evyd13/dodo67/README.md

# Dodo67 PCB

## Daughterboard
Doro67 replacement daughterboard PCB

Check out the daughterboard under `daughterboard/`.

## PCB
The Dodo67 PCB will be uploaded later.
