evyd13/dodo67/pcb/manufacturing/Dodo67 BOM.xls

Dodo67 BOM
Manufacturer | Manufacturer Part Number (required) | Designator (required) | Qty (required) | Description (required) | Case | SMD ,BGA,LCC,OR TH | Top/Bottom | points (number of contacts the IC has in each board) | Total points (number of contacts per BOM line has) | Comment
Samsung Electro-Mechanics | CL21B104KBCNNNC | C1-C3 | 3 | 100nf capacitor | 0805 | SMD | Bottom
Samsung Electro-Mechanics | CL21A475KAQNNNE | C4 | 1 | 4.7uf capacitor | 0805 | SMD | Bottom
Samsung Electro-Mechanics | CL21A105KBCLNNC | C5 | 1 | 1uf capacitor | 0805 | SMD | Bottom
LIZ Elec | CD4148WSP | D1-D31, D33-D47, D49-D63, D65-D67, D71, D74-D79 | 71 | Switching diode | 0805 | SMD | Bottom
Walsin Tech Corp | WR08X103JTL | R3, R4 | 2 | 10k ohm resistor | 0805 | SMD | Bottom
Walsin Tech Corp | WR08X220JTL | R1, R2 | 2 | 22 ohm resistor | 0805 | SMD | Bottom
Walsin Tech Corp | WR08X471JTL | R5 | 1 | 470 ohm resistor | 0805 | SMD | Bottom
Microchip Tech | ATMEGA32U4-AU | U1 | 1 | Microcontroller | QFP-44 | SMD | Bottom |  |  | Do not substitute
STMicroelectronics | USBLC6-2SC6 | U2 | 1 | Diode ESD | SOT-23-6 | SMD | Bottom |  |  | Do not substitute
Korean Hroparts Elec | K2-1187SQ-A4SW-06 | SW1 | 1 | Tactile switch |  | SMD | Bottom
Murata Electronics | CSTNE16M0V530000R0 | X1 | 1 | Resonator |  | SMD | Bottom |  |  | Do not substitute
TLC Electronic | TLC-PSMD050 | F1 | 1 | PTC Fuse | 0805 | SMD | Bottom |  |  | Do not substitute
JST Sales America | SM04B-SRSS-TB(LF)(SN) | J3 | 1 | Board connector |  | SMD | Bottom |  |  | Do not substitute
Worldsemi | WS2813B | RGB1-RGB8 | 8 | RGB LED | 5050 | SMD | Bottom |  |  | Do not substitute
