evyd13/dodo67/daughterboard/manufacturing/Dodo67 daughterboard BOM.xls

Dodo67 Daughterboard BOM
Manufacturer | Manufacturer Part Number (required) | Designator (required) | Qty (required) | Description (required) | Case | SMD ,BGA,LCC,OR TH | Top/Bottom | points (number of contacts the IC has in each board) | Total points (number of contacts per BOM line has) | Comment
Korean Hroparts Elec | TYPE-C-31-M-12 | J1 | 1 | USB-C female connector |  | SMD + TH | Top
JST Sales America | SM04B-SRSS-TB(LF)(SN) | J2 | 1 | Male board connector 1.00mm pitch |  | SMD | Top
TLC Electronic | TLC-PSMD050 | F1 | 1 | Polyfuse 500mA/1A | 0805 | SMD | Top
Walsin Tech Corp | WR08X512JTL | R1, R2 | 2 | 5.1k Ohm resistor | 0805 | SMD | Top
STMicroelectronics | USBLC6-2SC6 | U1 | 1 | ESD protection diode | SOT23-6 | SMD | Top
