evyd13/dodo67/daughterboard/daughterboard.kicad_pcb

## KiCad design daughterboard/daughterboard.kicad_pcb (2022-03-01)

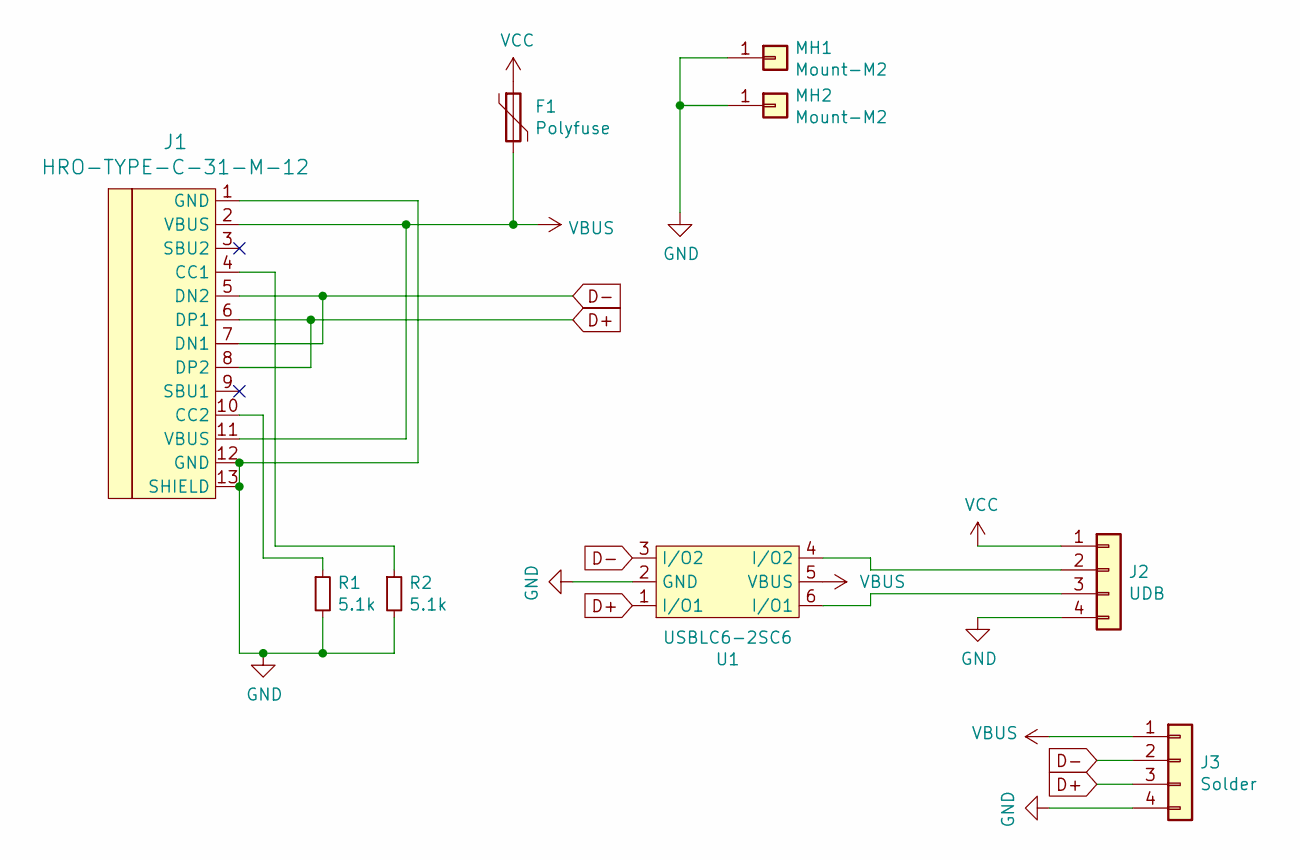
[picture p1: schematic daughterboard.kicad_sch]

Parts:
F1: Polyfuse; R_0805
J1: HRO-TYPE-C-31-M-12; CONN_HRO-TYPE-C-31-M-12
J2: UDB; CONN_JST_SH_SM04B-SRSS-TB_1x04-1MP_P1.00mm_Horizontal
J3: Solder; solder_header
MH1, MH2: Mount-M2; 3x2.2
R1, R2: 5.1k; R_0805
U1: USBLC6-2SC6; PACKAGE_SOT-23-6; Farnell 1295310

Connections:
D+: J1.6 (DP1), J1.8 (DP2), J3.3, U1.1 (I/O1)
D-: J1.5 (DN2), J1.7 (DN1), J3.2, U1.3 (I/O2)
GND: J1.1 (GND), J1.12 (GND), J1.13 (SHIELD), J2.4, J3.4, MH1.1, MH2.1, R1.2, R2.2, U1.2 (GND)
unnamed: J1.4 (CC1), R2.1
unnamed: J1.10 (CC2), R1.1
unnamed: J2.2, U1.4 (I/O2)
unnamed: J2.3, U1.6 (I/O1)
VBUS: F1.2, J1.2 (VBUS), J1.11 (VBUS), J3.1, U1.5 (VBUS)
VCC: F1.1, J2.1

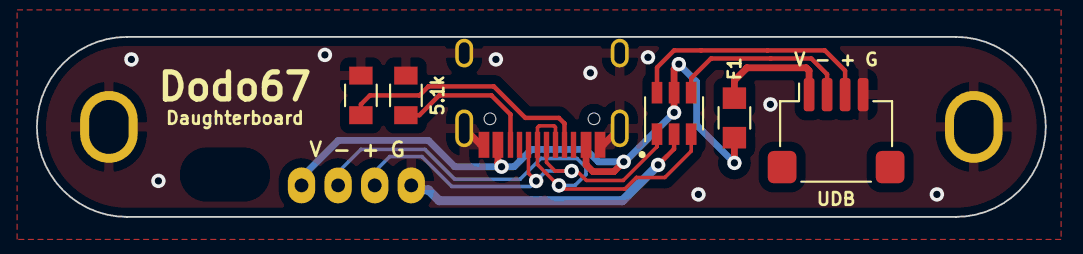
[picture p2: board daughterboard.kicad_pcb from above]

Board: 2 copper layers, 56.1 x 10.0 mm, 9 parts (0 on the bottom side), 9 nets.
