evyd13/dodo67/(commit log)

2022-03-01 Upload daughterboard files
    [Dodo67 daughterboard BOM.xls, daughterboard.kicad_pcb, daughterboard.kicad_sch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]
2022-03-10 upload pcb
    [Dodo67 BOM.xls, dodo67.kicad_sch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]
